suporteskoupa-coder/Monitoramento-energetico-Parte-2/experimentos/2026-08-04_campanha-01-diagnostica/evidencias/foto1.png

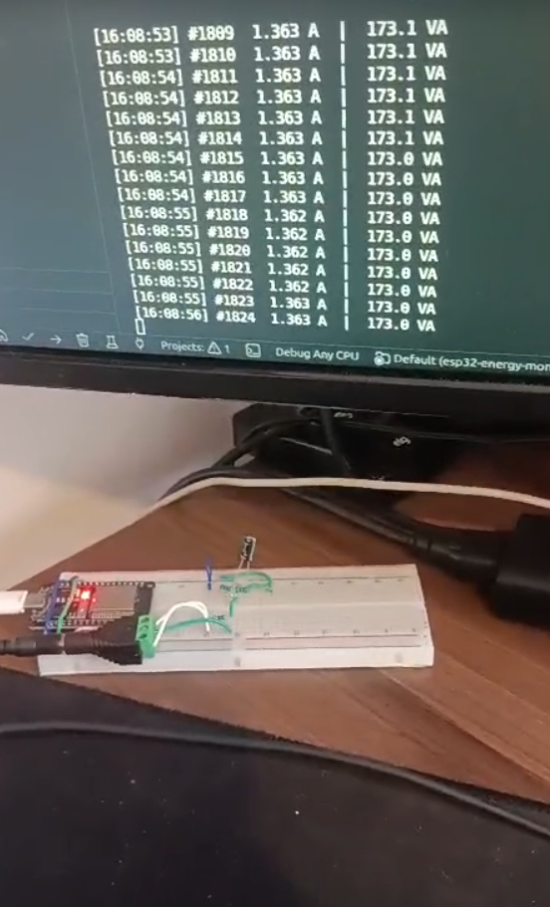
experimentos/2026-08-04_campanha-01-diagnostica/evidencias/foto1.png
