suporteskoupa-coder/Monitoramento-energetico-Parte-2/hardware/evidencias/fotos/P2.jpg

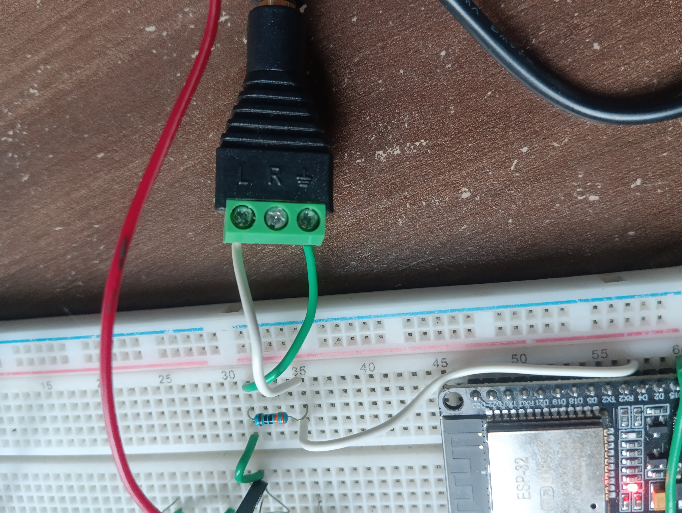
hardware/evidencias/fotos/P2.jpg
