suporteskoupa-coder/Monitoramento-energetico-Parte-2/historico/repositorio-compactado/README.md

# monitoramento-energetico
Monitoramento Energético de Equipamentos Elétricos com IoT de Baixo Custo e Análise Inteligente de Séries Temporais
# Título do Projeto

## Objetivo

## Equipe

## Cronograma

## Estrutura do Repositório

## Tecnologias Utilizadas
**Hardware:**
* Placa de Desenvolvimento **ESP32** (Módulo WROOM)
* Sensor de Corrente Não Invasivo **SCT-013-000** (100A/50mA)
* Componentes passivos (Resistores de precisão, Capacitores eletrolíticos de 10µF)
* Cabos jumper
## Organização das Pastas

## Referências

## Licença
