suporteskoupa-coder/Monitoramento-energetico-Parte-2/experimentos/2026-08-04_campanha-01-diagnostica/relatorios/controle-de-campanha.pdf

Controle de Campanhas

Campanha | Período | Local | Equipamento | Responsável | Firmware | Frequência | Ocorrências
Campanha 01 | 04–05/08 | Residência | ESP32 | Nathália | | * | 4 interrupções
Campanha 02 | — | — | — | — | — | — | —
Campanha 03 | — | — | — | — | — | — | —

OBS:

Frequência planejada: 1 Hz

Frequência observada: intervalos de 1 segundo nos trechos contínuos, com interrupções.
