suporteskoupa-coder/Monitoramento-energetico-Parte-2/docs/cronograma.md

# Cronograma por Dependências

O cronograma usa critérios de conclusão em vez de datas inventadas. Datas devem ser incluídas
pela equipe depois que responsáveis e disponibilidade de bancada forem confirmados.

| Ordem | Etapa | Responsável principal | Dependência | Evidência de conclusão | Estado |
|---:|---|---|---|---|---|
| 1 | definir firmware e aquisição oficiais | Mel | decisão da equipe | código executável, instrução única e CSV de teste | pendente |
| 2 | definir esquema único do CSV | Mel e Nathália | etapa 1 | produtor e pipeline com mesmas colunas | pendente |
| 3 | confirmar montagem real | Pedro | acesso à bancada | sensor, R1/R2, burden, GPIO, ponto médio e fotos | pendente |
| 4 | fechar regra da Campanha 01 | Nathália e orientador | análise das duas regras | decisão registrada e base coerente | pendente |
| 5 | executar teste-piloto | Mel, Pedro e Nathália | etapas 1–3 | uma linha/s, metadados, sem duplicidades e com relatório | pendente |
| 6 | concluir documentação independente da calibração | Fábio | informações disponíveis | README e documentos coerentes; pendências explícitas | Concluído |
| 7 | disponibilizar alicate amperímetro AC | orientador | disponibilidade externa | instrumento identificado e disponível | aguardando recurso externo |
| 8 | calibrar e validar corrente | Pedro e equipe | etapas 3, 5 e 7 | fator, tabela de pontos e erro de validação | bloqueada pela etapa 7 |
| 9 | realizar campanha definitiva | equipe | etapas 5 e 8 | protocolo, base bruta, base processada e qualidade | não iniciada |
| 10 | análise exploratória e IA | equipe | etapa 9 | análise reproduzível sobre campanha válida | não iniciada |

## Entregas documentais já disponíveis

- visão científica em [`projeto.md`](projeto.md);
- metodologia em [`metodologia.md`](metodologia.md);
- limites metrológicos em [`metrologia.md`](metrologia.md);
- controle de campanhas em [`controle_campanhas.md`](controle_campanhas.md);
- decisões e pendências em [`decisoes.md`](decisoes.md);
- fontes técnicas em [`referencias.md`](referencias.md).
- lista consolidada do que falta confirmar em
  [`pendencias_informacao.md`](pendencias_informacao.md).

## Informações ainda necessárias para inserir datas

- data da próxima reunião da equipe;
- disponibilidade de Pedro e Mel para o teste-piloto;
- previsão do orientador para o alicate amperímetro;
- duração aprovada do teste-piloto;
- prazo institucional do relatório parcial;
- data-alvo da campanha definitiva.
