suporteskoupa-coder/Monitoramento-energetico-Parte-2/docs/reunioes.md

# Reuniões e Encaminhamentos

## Situação do histórico

Não foram encontradas atas formais anteriores no estado atual do repositório. Para não
inventar participantes, datas ou decisões, este documento inicia o controle a partir da
regularização documental. Reuniões antigas só devem ser adicionadas se houver registro
verificável.

## Decisões que exigem reunião da equipe

| Prioridade | Tema | Participantes necessários | Produto esperado |
|---:|---|---|---|
| 1 | fluxo oficial de aquisição | Mel, Pedro e Nathália | uma arquitetura e instrução de execução |
| 2 | esquema único do CSV | Mel e Nathália | cabeçalho e exemplo aprovados |
| 3 | primeiro registro ou média | Nathália e orientador | regra metodológica e código alinhados |
| 4 | confirmação do SCT-013 | Pedro | modelo, burden, R1/R2 e esquema real |
| 5 | critérios de calibração | orientador e equipe | faixa, erro máximo e protocolo |
| 6 | licença | orientador e equipe | licença escolhida e arquivo no repositório |

O estado detalhado está em [`decisoes.md`](decisoes.md).

## Modelo de ata

```text
# Reunião AAAA-MM-DD

Horário:
Local ou meio:
Participantes:
Objetivo:

## Evidências analisadas
- arquivo, teste, dado ou relatório

## Discussão
- síntese objetiva dos pontos relevantes

## Decisões
- decisão, justificativa e artefatos afetados

## Pendências
| Ação | Responsável | Dependência | Evidência esperada |
|---|---|---|---|

## Próxima verificação
- condição de conclusão, não apenas uma data
```

## Regra de validade

Uma decisão registrada em ata deve ser transferida para `decisoes.md` e refletida nos
artefatos afetados. A existência da ata, sozinha, não valida firmware, montagem ou dados.
