suporteskoupa-coder/Monitoramento-energetico-Parte-2/experimentos/2026-08-04_campanha-01-diagnostica/relatorios/regra-de-consolidacao.pdf

Regra de Consolidação

Para a consolidação da Campanha Experimental 01, os registros serão organizados cronologicamente e será mantido um único registro por timestamp. Registros duplicados serão identificados e não serão utilizados na base consolidada. As lacunas temporais serão preservadas e registradas, sem preenchimento ou geração artificial de dados.

Se aplicarmos um registro por timestamp, chegamos aos: 16.709 registros consolidados.
