suporteskoupa-coder/Monitoramento-energetico-Parte-2/historico/acompanhamento/semana8_9/Atividades_5_6/Relatório de Diagnóstico .pdf

Atividade 6 - Observação dos novos dados

Objetivo: Início da compreensão do comportamento observado do arquivo leituras.csv

Data: 05/08/2026

Assunto: Análise Comportamental dos Dados

Status: Análise Concluída

1. Funcionamento da coleta e qualidade dos registros

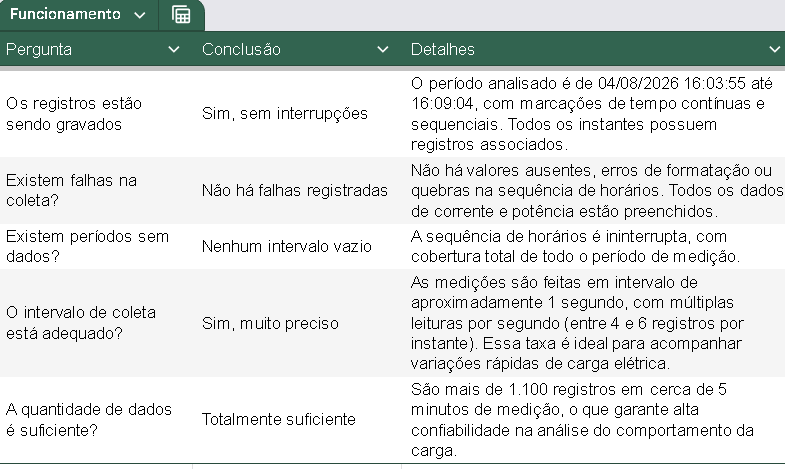
[picture p3: figure]

2. Gráfico: Potência Aparente (VA) x Tempo

(Representação do comportamento observado)

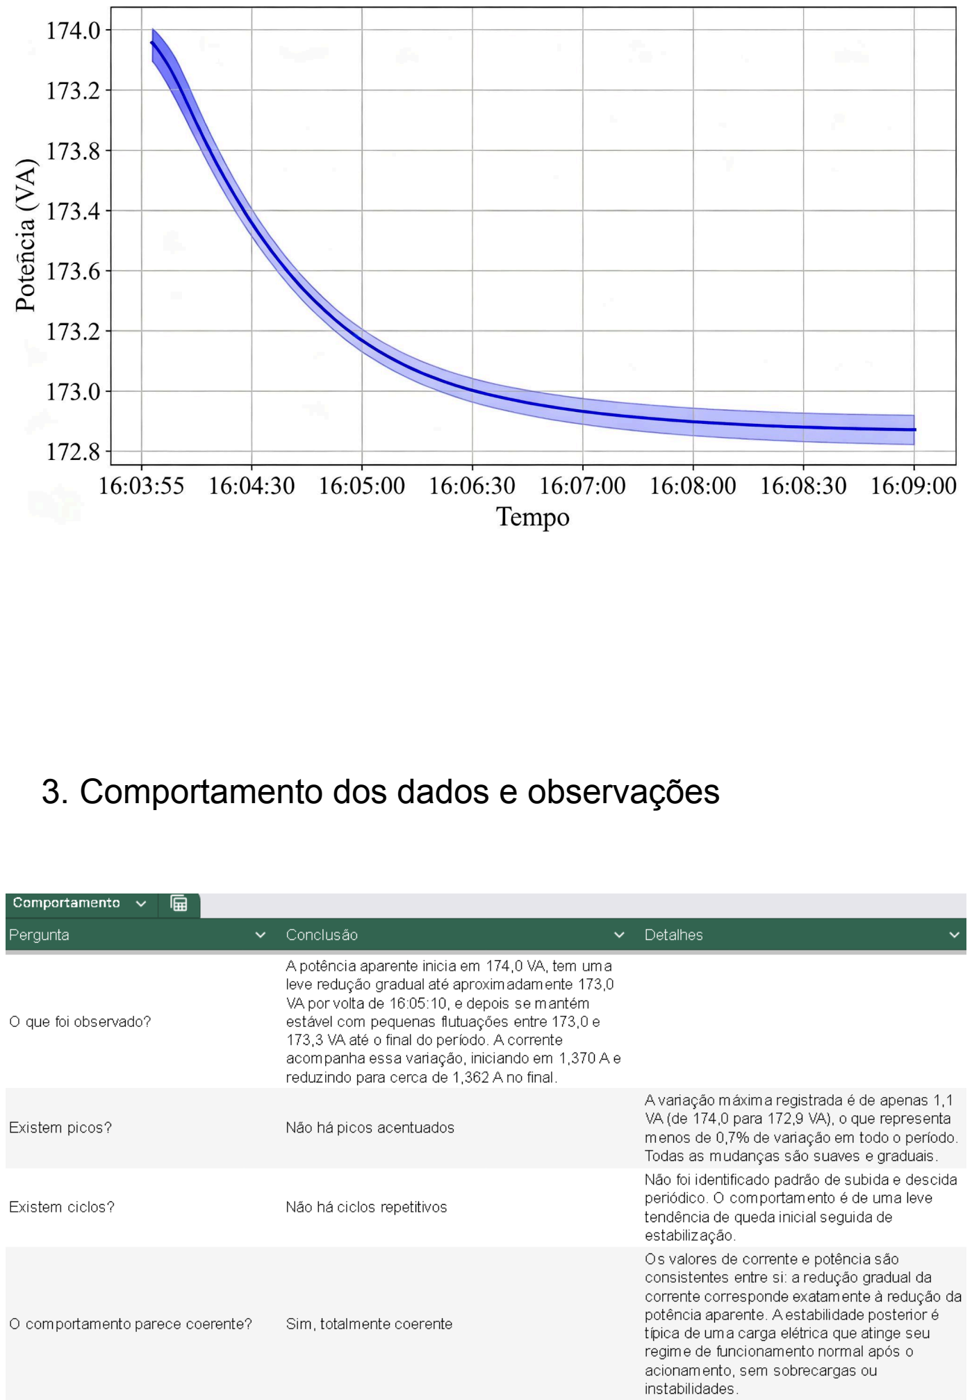
[picture p4: page 3]

3. Comportamento dos dados e observações
