suporteskoupa-coder/Monitoramento-energetico-Parte-2/hardware/esquematicos/divisorTensao.png

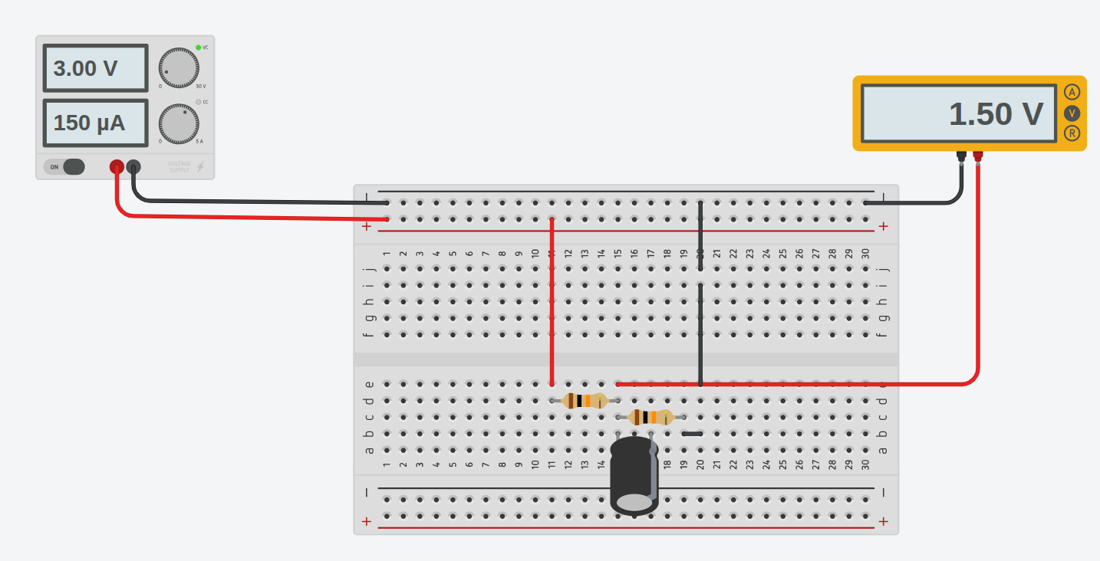
hardware/esquematicos/divisorTensao.png
