suporteskoupa-coder/Monitoramento-energetico-Parte-2/hardware/evidencias/fotos/CI.jpg

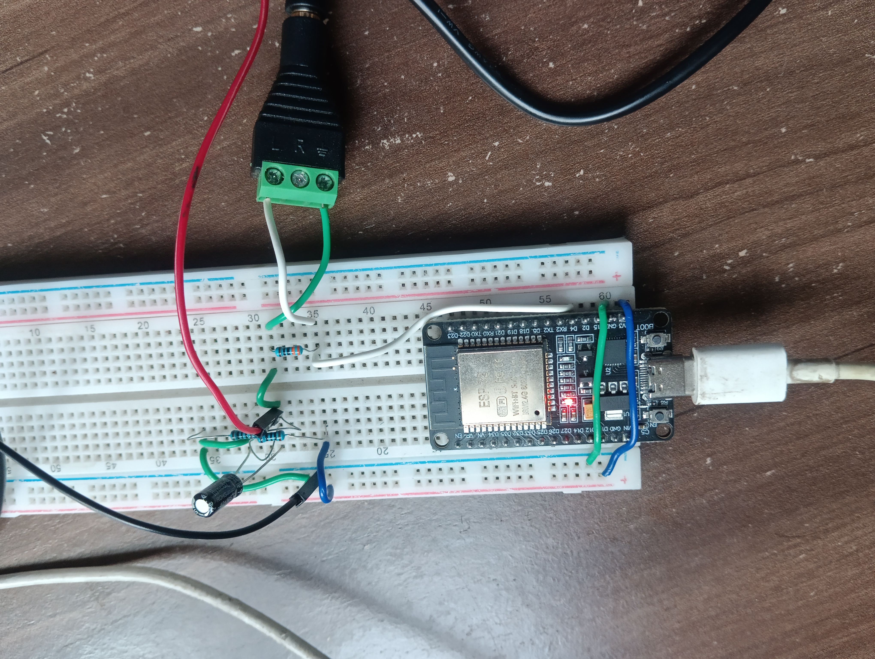
hardware/evidencias/fotos/CI.jpg
