suporteskoupa-coder/Monitoramento-energetico-Parte-2/hardware/evidencias/fotos/Div_tensao.jpg

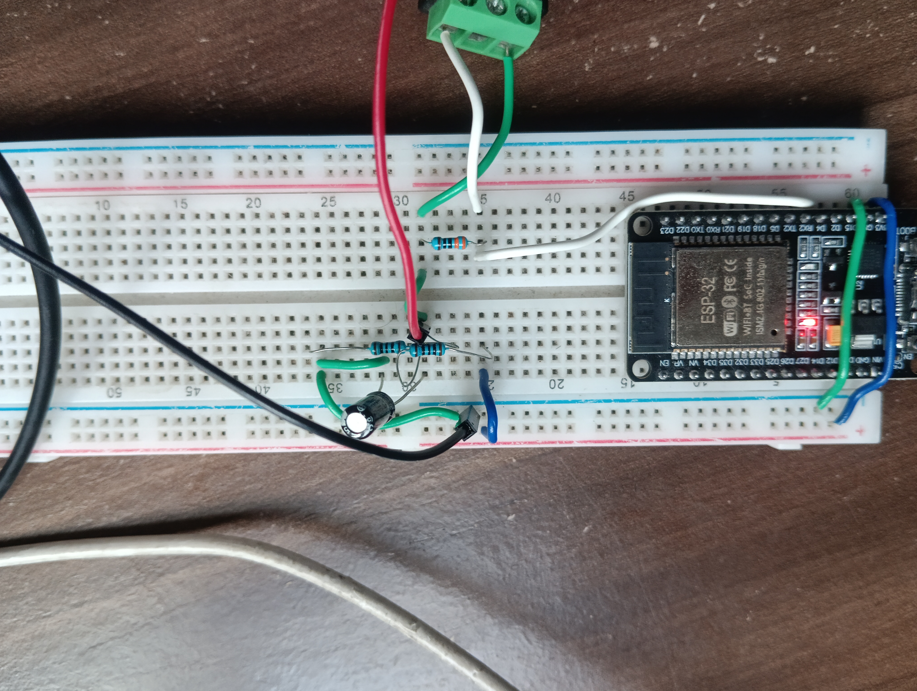
hardware/evidencias/fotos/Div_tensao.jpg
