suporteskoupa-coder/Monitoramento-energetico-Parte-2/hardware/evidencias/fotos/multimetro_divisor.jpg

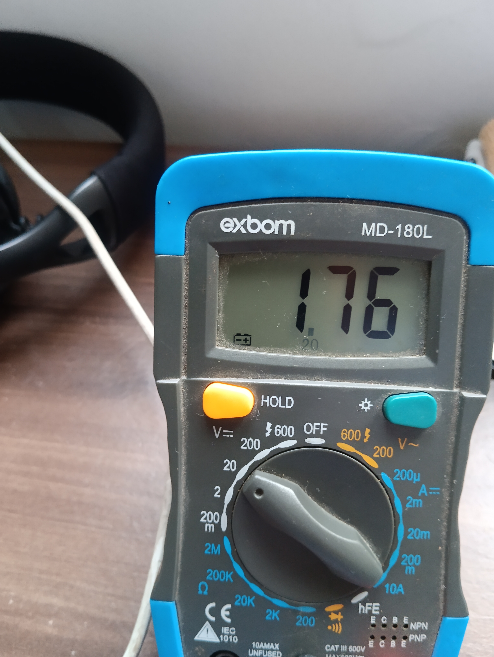
hardware/evidencias/fotos/multimetro_divisor.jpg
