suporteskoupa-coder/Monitoramento-energetico-Parte-2/historico/acompanhamento/semana/semana1_/Funky Crift-Hango.png

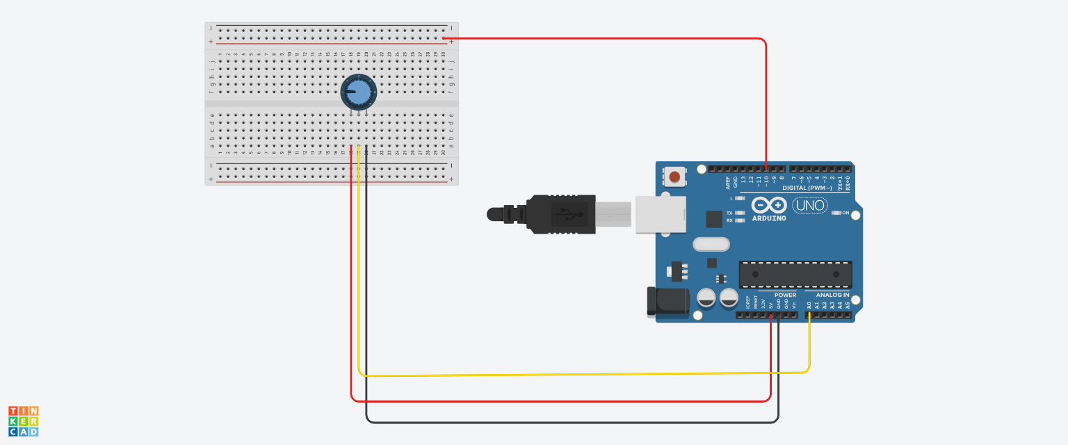
historico/acompanhamento/semana/semana1_/Funky Crift-Hango.png
