suporteskoupa-coder/Monitoramento-energetico-Parte-2/historico/acompanhamento/semana/semana6_7/atividades/jackp2.webp

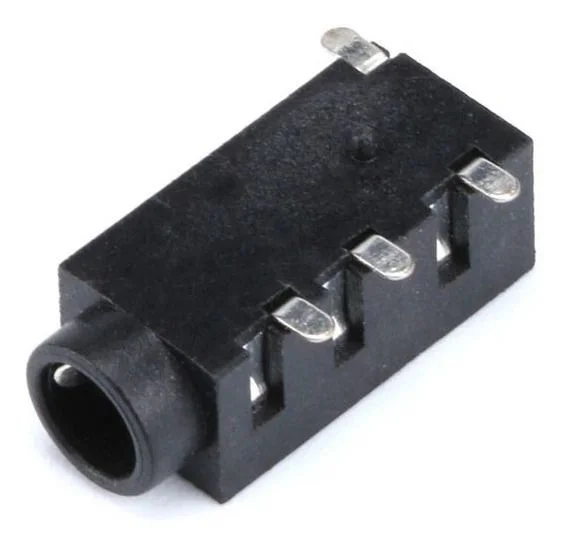
historico/acompanhamento/semana/semana6_7/atividades/jackp2.webp
