suporteskoupa-coder/Monitoramento-energetico-Parte-2/historico/acompanhamento/semana/semana6_7/tema1/ads1115-ADC-with-esp32.jpeg

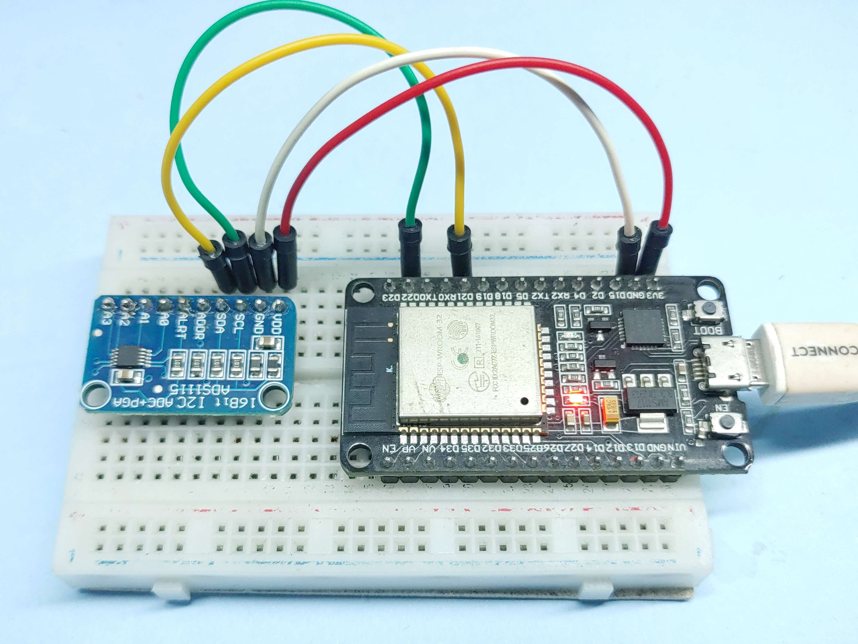
historico/acompanhamento/semana/semana6_7/tema1/ads1115-ADC-with-esp32.jpeg
