suporteskoupa-coder/Monitoramento-energetico-Parte-2/historico/acompanhamento/semana/semana6_7/tema1/ADS1115-external-ADC-with-ESP32.webp

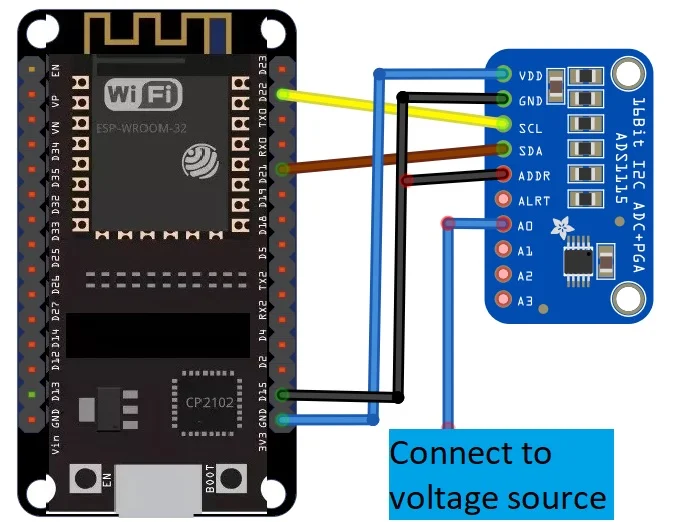
historico/acompanhamento/semana/semana6_7/tema1/ADS1115-external-ADC-with-ESP32.webp
