suporteskoupa-coder/Monitoramento-energetico-Parte-2/historico/acompanhamento/semana/semana6_7/tema1/sct013_corrente_alternadaTK.webp

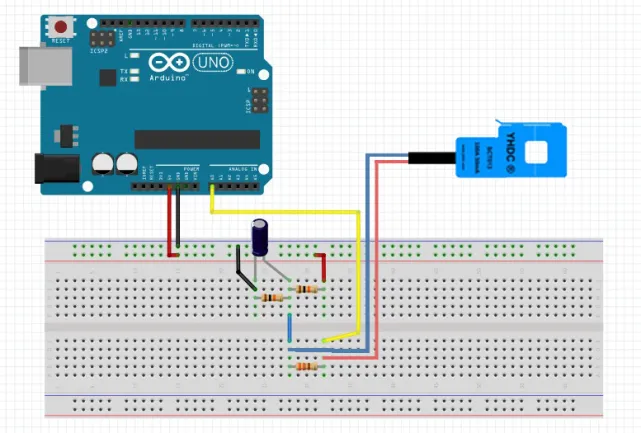
historico/acompanhamento/semana/semana6_7/tema1/sct013_corrente_alternadaTK.webp
