suporteskoupa-coder/Monitoramento-energetico-Parte-2/historico/acompanhamento/semana/semana6_7/tema2/FILTRO_PASSA_BASSO_RCtk.png

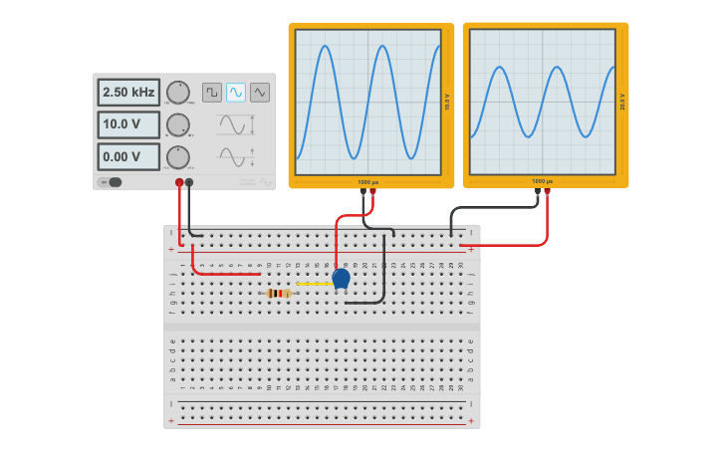
historico/acompanhamento/semana/semana6_7/tema2/FILTRO_PASSA_BASSO_RCtk.png
