suporteskoupa-coder/Monitoramento-energetico-Parte-2/historico/acompanhamento/semana/semana6_7/tema2/ilustracao_scrt013.jpg

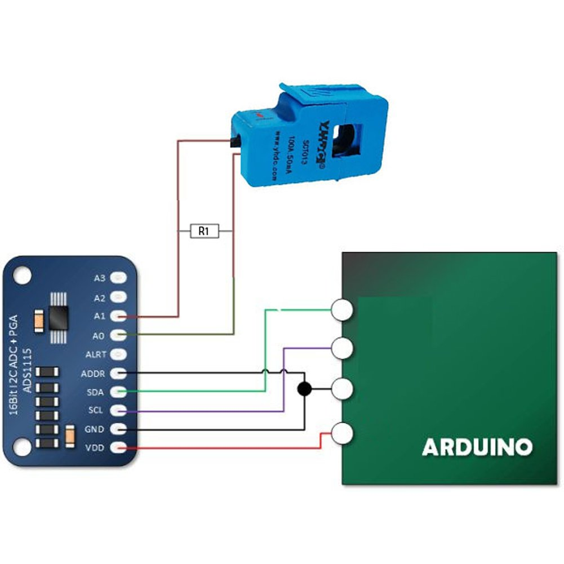
historico/acompanhamento/semana/semana6_7/tema2/ilustracao_scrt013.jpg
