suporteskoupa-coder/Monitoramento-energetico-Parte-2/historico/acompanhamento/semana/semana6_7/tema2/nucleo_magnetico_ferrite.jpg

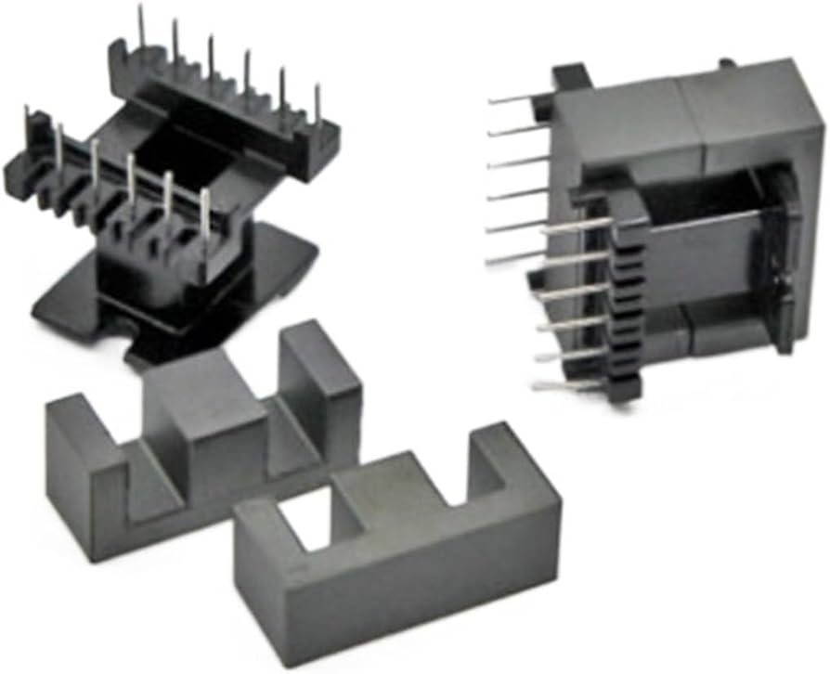
historico/acompanhamento/semana/semana6_7/tema2/nucleo_magnetico_ferrite.jpg
