suporteskoupa-coder/Monitoramento-energetico-Parte-2/historico/acompanhamento/semana/semana6_7/tema2/saida_em_tensao_SCT-013-050.webp

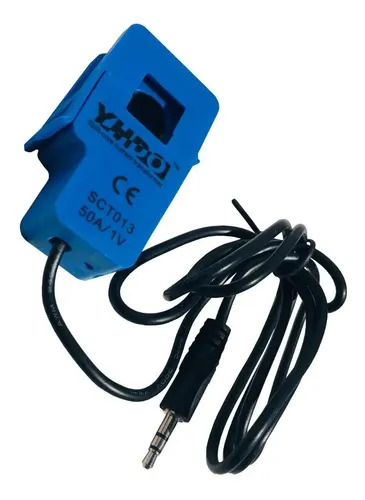
historico/acompanhamento/semana/semana6_7/tema2/saida_em_tensao_SCT-013-050.webp
