suporteskoupa-coder/Monitoramento-energetico-Parte-2/historico/acompanhamento/semana/semana6_7/tema2/saida_tensao_SCT-013-030.jpg

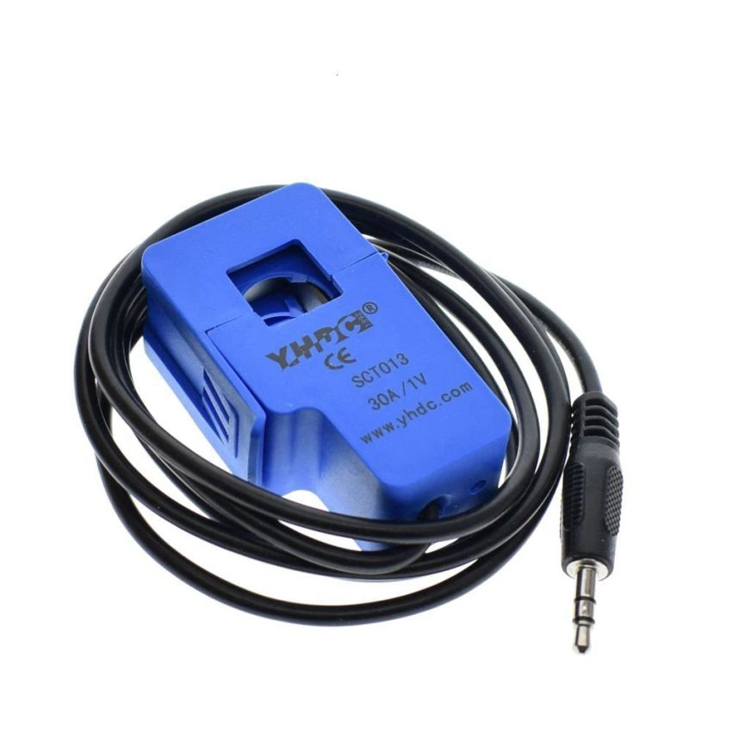
historico/acompanhamento/semana/semana6_7/tema2/saida_tensao_SCT-013-030.jpg
