suporteskoupa-coder/Monitoramento-energetico-Parte-2/historico/acompanhamento/semana/semana6_7/tema2/sct013_sensor_correntenaoinvasivo_100a.png

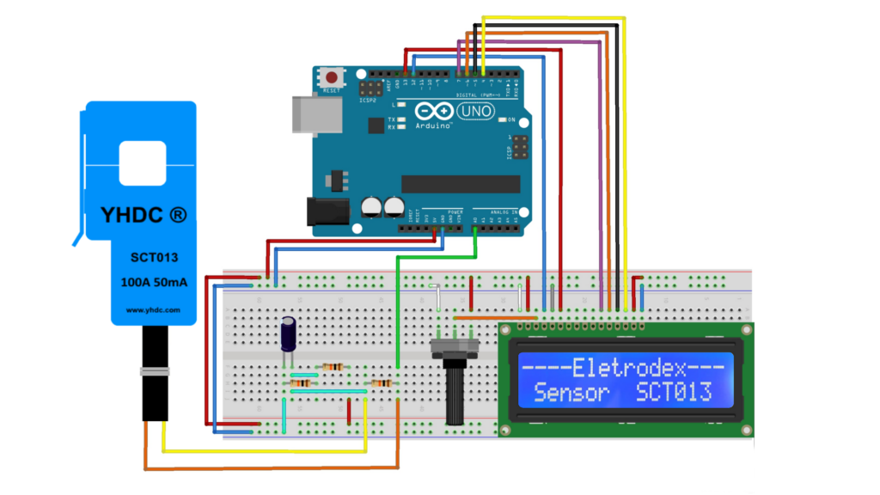
historico/acompanhamento/semana/semana6_7/tema2/sct013_sensor_correntenaoinvasivo_100a.png
