suporteskoupa-coder/Monitoramento-energetico-Parte-2/historico/acompanhamento/semana/semana6_7/tema2/SCT-013-DESTAQUE.webp

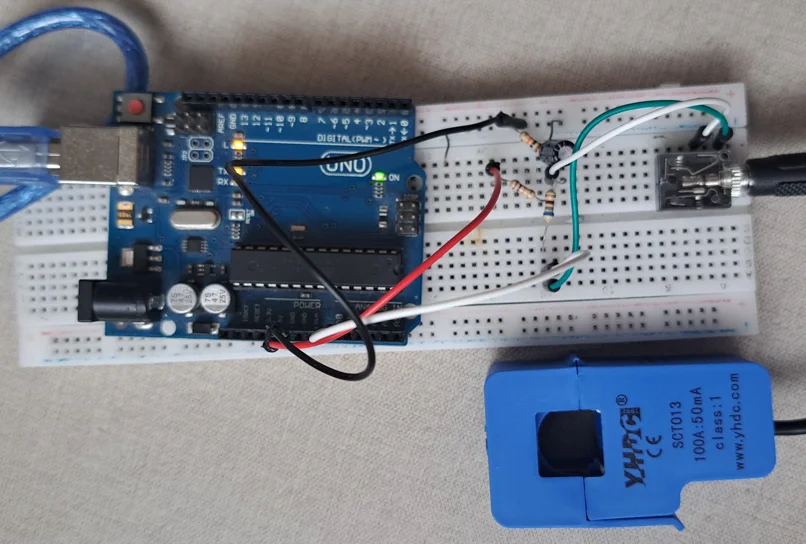
historico/acompanhamento/semana/semana6_7/tema2/SCT-013-DESTAQUE.webp
