suporteskoupa-coder/Monitoramento-energetico-Parte-2/historico/acompanhamento/semana/semana6_7/tema2/sensor_sct013_saidaemCorrtente.jpg

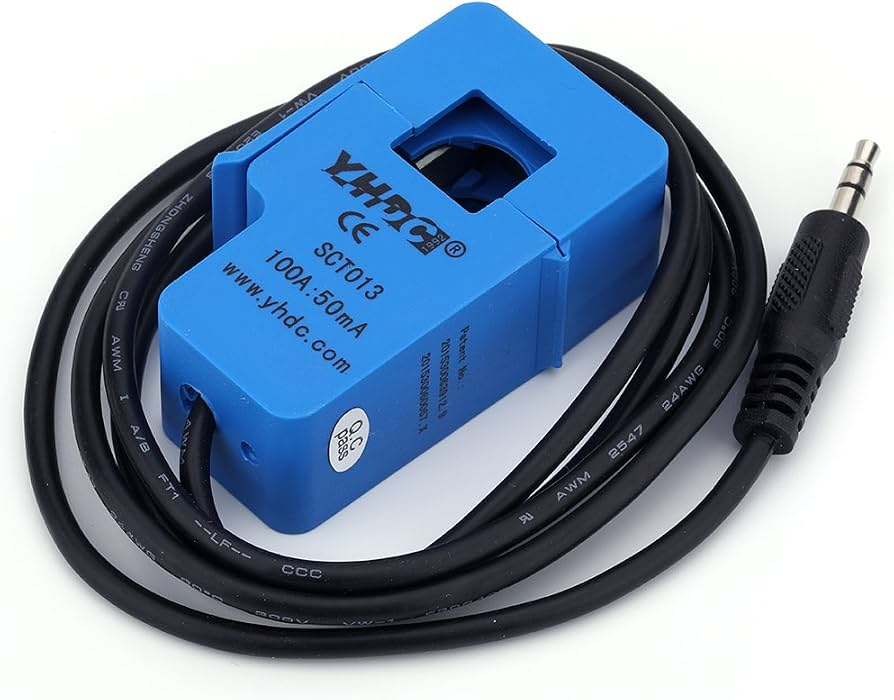
historico/acompanhamento/semana/semana6_7/tema2/sensor_sct013_saidaemCorrtente.jpg
