suporteskoupa-coder/Monitoramento-energetico-Parte-2/historico/acompanhamento/semana/semana6_7/tema2/SIMULACAO_passa_baixas_TK.png

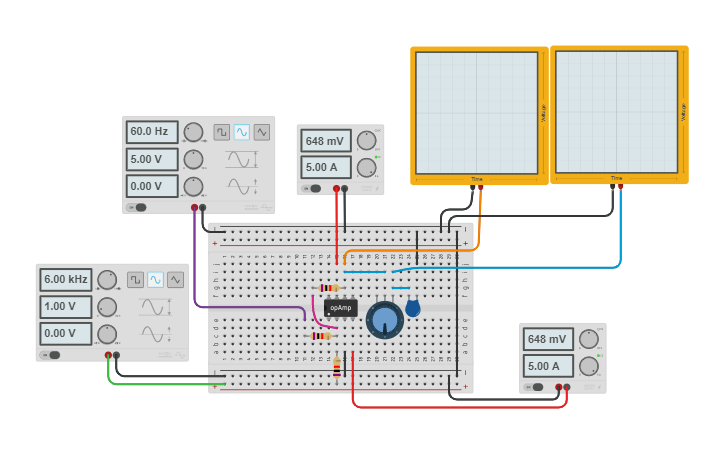
historico/acompanhamento/semana/semana6_7/tema2/SIMULACAO_passa_baixas_TK.png
