suporteskoupa-coder/Monitoramento-energetico-Parte-2/historico/acompanhamento/semana/semana6_7/tema2/MontagemIdeal.jpeg

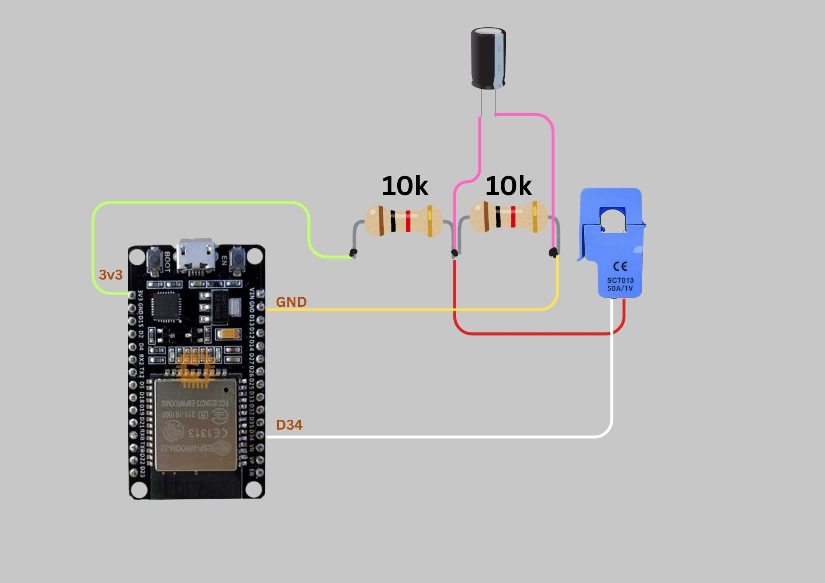
historico/acompanhamento/semana/semana6_7/tema2/MontagemIdeal.jpeg
