suporteskoupa-coder/Monitoramento-energetico-Parte-2/experimentos/2026-08-04_campanha-01-diagnostica/relatorios/campanha-experimental-corrigida.pdf

### Campanha Experimental Corrigida

Informações/Resultados

Data inicial: 04/08/2026

Início: 16:03:55

Término: 05/08/2026 às 08:37:56

Equipamento: ESP32

Local: residência

Duração: 16h 34min 1s

Total de registros: 101.244

Timestamps diferentes: 16.709

Frequência observada: A aquisição apresentou intervalos de 1 segundo nos trechos contínuos, porém houve interrupções na sequência temporal, de modo que a campanha não manteve 1 Hz durante todo o período

OBS: SEGUE AS INTERRUPÇÕES

Interrupção 1:

16:30:10

↓

6 horas, 27 minutos e 36 segundos sem registro

↓

22:57:46

Interrupção 2:

23:06:44

↓

37 segundos

↓

23:07:21

Interrupção 3:

23:12:54

↓

7 minutos e 17 segundos

↓

23:20:11

Interrupção 4:

01:23:04

↓

5 horas, 20 minutos e 7 segundos sem registro

↓

06:43:11

Conclusão: A Campanha 01 durou 16h34min01s, teve 101.244 registros e apresentou trechos com intervalo de 1 segundo entre timestamps. Porém, a aquisição não foi contínua e ocorreram quatro interrupções importantes. Portanto, o relatório não deve afirmar que a campanha foi contínua nem que manteve 1 Hz durante todo o período
