suporteskoupa-coder/Monitoramento-energetico-Parte-2/experimentos/2026-08-04_campanha-01-diagnostica/relatorios/campanha-experimental-original.pdf

Campanha Experimental 01

Data: 04/08/2026

Equipamento monitorado: ESP32- Computador

Local da coleta: residência

Frequência de aquisição: 1 Hz

Duração da campanha: 16 horas, 34 minutos e 1 segundo

Firmware: v1.0

Total de registros: 101.244

Base consolidada: 16.709

Registros Duplicados: 84.535

Observações:

- Após a consolidação dos dados, a base final possui 16.709 registros únicos, representando corretamente a campanha de aquisição.
- Não foram identificadas interrupções relevantes na sequência temporal dos registros consolidados, indicando uma aquisição contínua durante toda a campanha.
