suporteskoupa-coder/Monitoramento-energetico-Parte-2/experimentos/2026-08-04_campanha-01-diagnostica/README.md

# Campanha 01 — diagnóstica

Coleta realizada entre 04/08/2026 16:03:55 e 05/08/2026 08:37:56. Ela foi preservada para
diagnóstico de duplicidades, lacunas e fluxo de aquisição; não é uma campanha calibrada.

## Artefatos

- base bruta: [`../../dados/brutos/campanha-01/leituras.csv`](../../dados/brutos/campanha-01/leituras.csv);
- bases derivadas: [`../../dados/processados/campanha-01/`](../../dados/processados/campanha-01/);
- fotografia recuperada do pacote da campanha: [`evidencias/foto1.png`](evidencias/foto1.png);
- relatório corrigido: [`relatorios/campanha-experimental-corrigida.pdf`](relatorios/campanha-experimental-corrigida.pdf);
- relatório original: [`relatorios/campanha-experimental-original.pdf`](relatorios/campanha-experimental-original.pdf);
- controle: [`relatorios/controle-de-campanha.pdf`](relatorios/controle-de-campanha.pdf);
- duplicidades: [`relatorios/duplicidades.pdf`](relatorios/duplicidades.pdf);
- regra de consolidação: [`relatorios/regra-de-consolidacao.pdf`](relatorios/regra-de-consolidacao.pdf).

Os metadados conhecidos, indicadores e interrupções estão em
[`../../docs/controle_campanhas.md`](../../docs/controle_campanhas.md).
