suporteskoupa-coder/Monitoramento-energetico-Parte-2/experimentos/_modelo/README.md

# Identificador e nome da campanha

## Antes da coleta

| Campo | Preenchimento |
|---|---|
| ID da campanha | PENDENTE |
| Classificação | PENDENTE |
| Objetivo/hipótese | PENDENTE |
| Equipamento monitorado | PENDENTE |
| Local e responsáveis | PENDENTE |
| Início e duração planejados | PENDENTE |
| Sensor e identificação | PENDENTE |
| Montagem/esquema | PENDENTE |
| Firmware, versão e commit | PENDENTE |
| Frequência e timestamp | PENDENTE |
| Armazenamento | PENDENTE |
| Instrumento/calibração | PENDENTE |
| Critérios de interrupção | PENDENTE |

## Depois da coleta

Registre início e término observados, quantidade de linhas, timestamps únicos, frequência,
duplicidades, lacunas, reinícios, ocorrências, arquivos brutos e processados, relatório de
qualidade e conclusão sobre a validade da campanha.

Use as subpastas `evidencias/` e `relatorios/`. Dados tabulares permanecem em `dados/`.
