suporteskoupa-coder/Monitoramento-energetico-Parte-2/historico/aprendizado/relembrando/basico/variaveis/variaveis.ino

void setup() {
  // put your setup code here, to run once:

  pinMode(10, OUTPUT);
  pinMode(9, OUTPUT);

}

void loop() {
  // put your main code here, to run repeatedly:

  // Em vez de ficar usando delay vamos criar uma variável

  int intervaloPisca;
  intervaloPisca = 200;


  digitalWrite(10, HIGH);
  digitalWrite(9, LOW);

  delay(intervaloPisca);

  digitalWrite(10, LOW);
  digitalWrite(9, HIGH);

   delay(intervaloPisca);



}
